FumBlau/BlauPlot/README.md

# BlauPlot
Código e instrucciones del reloj robot. Basado en el trabajo de elprofegarcia.com y Johannes Heberlein https://github.com/9a/plotclock

Codigo bajo licencia GPL v3, incluida en el repositorio. El resto de documentos están bajo licencia Creative Commons, by attribution, Share-alike, tambiñen incluida.
