FumBlau/BlauPlot/(commit log)

2017-07-26 estandarización de readme
2017-08-01 revisión de codigo de Justo
